jordan-malovini/sabia/hardware/caixa-3d/render-por-dentro.png

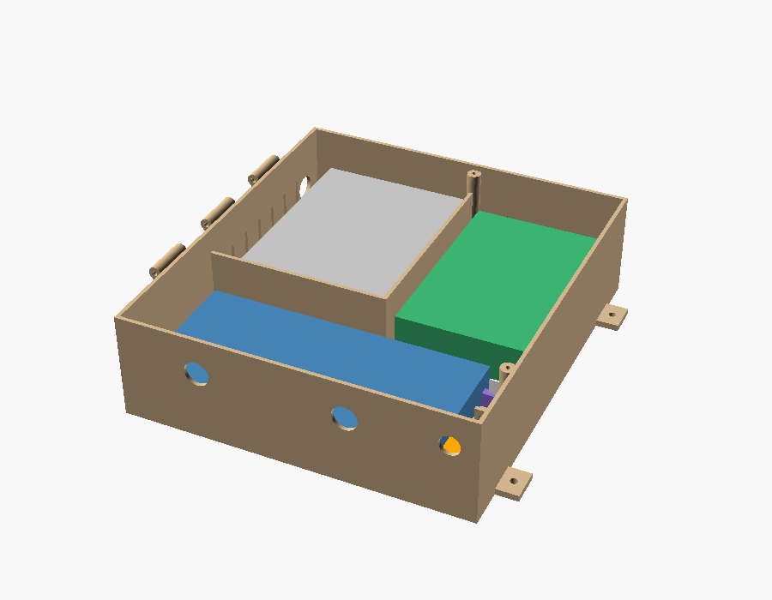
hardware/caixa-3d/render-por-dentro.png
