jordan-malovini/sabia/hardware/caixa-3d/render-tampa.png

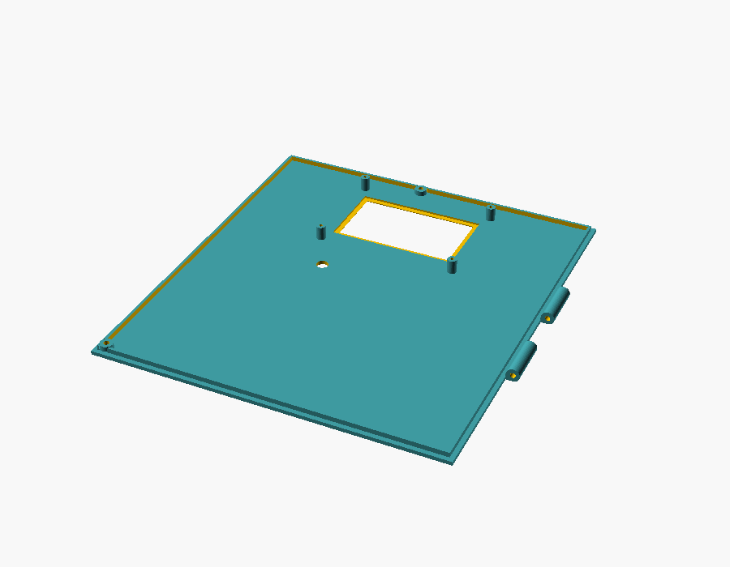
hardware/caixa-3d/render-tampa.png
