jordan-malovini/sabia/docs/diario/2026-11-11.md

# Diário: 11 de novembro de 2026

## O que fiz
- Concluí a tarefa #26: pesquisar e escolher os modelos 3D da estação meteorológica.

## O que descobri ou decidi
Modelos escolhidos:
- **Pluviômetro:** [Rain Gauge](https://www.printables.com/model/130513-rain-gauge) (Printables).
- **Abrigo anti-radiação do BME280:** [Hardware-free radiation shield](https://www.printables.com/model/1124805-hardware-free-radiation-shield-for-environmental-m) (Printables), que monta sem parafusos.
- **Cápsula do sensor de luz:** [VEML 7700 outdoor case](https://makerworld.com/pt/models/499883-veml-7700-outdoor-case#profileId-909237) (MakerWorld), feita para o VEML7700.

## Problemas
- Nenhum.

## Próximo passo
- Imprimir os três modelos em PETG ou ASA.
- Conferir no modelo do pluviômetro o volume por basculada, para ajustar `mmPorBasculada` na calibração.
- Seguem pendentes: medir os itens MEDIR da caixa quando as peças chegarem (#16) e rodar o firmware no Wokwi.
