jordan-malovini/sabia/docs/diario/2026-11-10.md

# Diário: 10 de novembro de 2026

## O que fiz
- **Medidas dos componentes (#16):** anotei as dimensões do ESP32-S3, do módulo de 16 relés, do RTC, da fonte e da placa de expansão. As da tela vieram do desenho do fabricante: placa de 93 × 70 mm, furos Ø3 a 88 × 65 mm, área visível de 72 × 40 mm e 13,5 mm de profundidade.
- **Caixa do controlador em OpenSCAD** (`hardware/caixa-3d/caixa.scad`, PRs #22, #23 e #24):
  - Base com os relés embaixo, a fonte num compartimento isolado, o ESP com a placa de expansão, suportes com parafuso, prensa-cabos, ventilação e abas de parede.
  - Tampa com dobradiça, tela atrás de um visor de acrílico, encoder e dois parafusos de fechamento.
  - Tamanho: 217,2 × 240,2 × 69,8 mm.
- **Visualização:** componentes coloridos e os modos `por_dentro`, `montagem` (transparente) e `aberta`.
- **microSD e RTC:** o microSD (18,5 × 17,5 × 5 mm, furos a 14 mm) fica em pé numa paredinha, com o cartão para a tampa e os pinos para o ESP. O RTC fica deitado sobre 3 suportes, com a pilha para a frente.
- **GitHub Actions "Caixa 3D":** gera os STL e as imagens a cada mudança e falha em qualquer aviso.
- Documentação em `docs/caixa.md` e desenho do leiaute em `tools/leiaute_caixa.py`.

## O que descobri ou decidi
- **OpenSCAD** para a caixa: o projeto é um arquivo de texto, com as medidas no topo, e cabe bem no Git.
- A fonte fica isolada por divisórias, porque é a única parte com tensão da rede. A entrada da rede é pela lateral.
- As divisórias param abaixo da tela (49,5 mm), o que permite a tela centralizada na tampa.
- No OpenSCAD, a prévia (F5) mostra cores e transparência; a renderização (F6) serve só para exportar o STL.
- A base precisa de uma impressora com mesa de pelo menos 250 × 250 mm.

## Problemas
- Conflitos de encaixe achados no leiaute e corrigidos: prensa-cabos da rede batendo na fonte, furos de baixo batendo nos módulos, tela sobre a divisória e parafusos de fechamento sobre o ESP e, depois, sobre o RTC.
- Os componentes não apareciam no OpenSCAD (fantasmas quase invisíveis e tampa fechada). Resolvido com as cores e os modos de visualização.
- O módulo microSD estava com medidas estimadas bem maiores que as reais.

## Próximo passo
- Quando as peças chegarem, medir com paquímetro os itens **MEDIR**: furos das placas de relés, de expansão e da fonte; os 3 furos do RTC; a altura dos furos e o lado dos pinos do microSD; a moldura da tela; o eixo do encoder.
- Confirmar o tamanho da mesa da impressora.
- A tarefa #16 continua em "Fazendo" até as medidas serem conferidas.
- Continuam pendentes: rodar o firmware no Wokwi, confirmar o modelo do ESP (#1) e a impressão do pluviômetro (#4).
