jordan-malovini/sabia/CHANGELOG.md

# Changelog

Formato: uma seção por versão, da mais nova para a mais antiga.

## [0.1] - em desenvolvimento

### Adicionado
- Estrutura do firmware no PlatformIO, com ambientes para o Wokwi, para a placa N16R8 e para testes no computador.
- Controlador de setores: fila com um setor por vez, modo ciclo, pular, parar setor e parar tudo, e tempo máximo por rega (RF01 a RF04, RF13).
- Sequência válvula e bomba: a bomba liga 2 s depois de a válvula abrir e desliga 1 s antes de ela fechar, com pausa de 3 s entre setores (RF05).
- Saídas configuradas como desligadas antes de virarem saída, no boot (RF14).
- Circuito do Wokwi com LEDs no lugar dos relés e comandos pelo monitor serial.
- 12 testes automáticos da fila e da sequência.
- GitHub Actions: testes e compilação do firmware a cada PR e push na `main`.
- Página web local (`firmware/data/index.html`): painel, histórico e ajustes completos, com modo demonstração enquanto o firmware não tem a API.
- Contrato da API entre a página e o firmware (`docs/api.md`).
- 31 testes de interação da página no Chrome sem janela (`tests/pagina/`).
- Logo do SABIÁ em `assets/logo/` (horizontal, com galho, só o pássaro e ícone), aplicada no README, como favicon e no topo da página web, e em 1 bit para a tela de boot do display (`firmware/include/logo_boot.h`).
- Caixa do controlador em OpenSCAD (`hardware/caixa-3d/caixa.scad`): base com divisórias, suportes, berços, prensa-cabos e abas de parede; tampa com dobradiça, tela atrás de visor de acrílico e encoder. STL gerados no GitHub Actions. Documentação em `docs/caixa.md`.
- Caixa: microSD em pé numa paredinha com 2 parafusos (cartão para a tampa, pinos para o ESP) e RTC deitado sobre 3 suportes, no lugar dos berços.
- Interface local: tela de 128x64 com a logo no boot, tela de estado e menu pelo encoder (escolher o setor, depois o tempo). Relógio e contagem de chuva do pluviômetro na tela.
- Simulação no Wokwi com tela, encoder, relógio e botão de pluviômetro.
- Monitor serial com eco do que é digitado e o comando `l` em duas etapas.
- Troca entre setores com sobreposição de 2 s e a bomba ligada do começo ao fim da fila (ideia do controlador antigo), em vez de desligar a bomba a cada setor.
- Agenda de regas com 3 programas (A, B, C): até 4 horários de início, dias da semana, ímpares, pares ou a cada N dias, tempo por setor e ajuste de 5 a 200 %. Empilhamento de programas, pausa por chuva de até 14 dias, próxima rega na tela e gravação na memória do ESP. Modelo baseado em controladores Rain Bird e Hunter.
- 14 testes da agenda, incluindo o defeito do controlador antigo (regar todos os dias no mesmo horário).
- Retomada depois de queda de energia: o setor atual, o tempo que falta e a fila são gravados; ao voltar, espera 10 min e retoma, com opção de retomar na hora ou cancelar, e descarta se a energia ficou fora por mais de 2 h.
- Edição da agenda pelo encoder ("Programar agenda"): ligar o programa, horários de início, dias (semana, ímpares, pares, intervalo), tempo de cada setor e ajuste.
- Página web no modelo de programas: agenda A, B e C nos Ajustes (horários, dias, tempo por setor, ajuste), pausa por chuva, "Iniciar programa" no painel, próxima rega por programa e ajustes de retomada e de sobreposição. `docs/api.md` atualizado; a página passa a ter 54 testes.
- Wi-Fi e servidor web no firmware: a página deixa de ser só demonstração e passa a comandar o controlador (estado, ligar, parar, programas, pausa por chuva, ajustes, retomada). A página vai embutida no firmware, numa gravação só. Rede própria (AP) com senha quando o Wi-Fi da casa falha, endereço `sabia.local`, sessão por senha (RF16) e servidor em tarefa separada, para a rede nunca atrasar válvulas e bomba.
- Limite de tempo por setor e setor desativado valem para todos os caminhos (agenda, página, encoder e serial).
- Comandos de serial `wifi`, `wifi NOME SENHA` e `senha padrao`.
- 11 testes da conversão JSON da API (`firmware/test/test_api`) e 16 testes da página contra um controlador simulado (`tests/pagina/teste-api.mjs`).
- Watchdog (RF15): se o programa travar por 15 s, o ESP reinicia com tudo desligado e a rega segue pela retomada.
- Sensores de clima: BME280 (temperatura, umidade, pressão) e VEML7700 (luz). Sem sensor, a leitura fica vazia e o resto segue normal.
- Registro (RF06, RF11): um CSV por dia com chuva a cada 10 min, clima por hora, regas e eventos, no cartão microSD ou, sem cartão, na memória do ESP. Histórico de hoje, 7 e 30 dias na página, com download em CSV.
- Balanço hídrico (RF08): ET0 por Hargreaves, saldo de água por setor e ajuste do tempo das regas automáticas. Só economiza: encurta ou pula, nunca passa do tempo do programa, e não interfere sem dados confiáveis. Adiamento automático quando chove mais que o limite em 24 h.
- Envio do registro ao Google Drive por Apps Script (`tools/drive/Codigo.gs`, passo a passo em `docs/drive.md`), apagando do cartão só depois da confirmação.
- Janela de horário por setor (RF13) nas regas da agenda, inclusive atravessando a meia-noite. Setor fora da janela, sem precisar de água ou com a rega encurtada pelo balanço fica anotado nos eventos.
- Relógio acertado pela internet (NTP) quando o Wi-Fi da casa conecta e uma vez por dia, no fuso escolhido.
- Display: tela apaga depois de um tempo sem uso (o primeiro toque só acende) e opção de travar os comandos, deixando ligar e parar só pela página.
- Script do Fusion (`hardware/caixa-3d/fusion/SabiaCaixa`) que desenha a caixa como projeto nativo, para editar pela linha do tempo. Passo a passo em `docs/caixa.md`.
- Caixa Rev B no Fusion: mais espaço para os fios dos bornes do ESP e das válvulas e para o fusível da rede (250 × 260 × 70 mm), gabarito da tela para testar o encaixe e tampa que abre na dobradiça. Os blocos dos componentes saíram.
- Nome do projeto: SABIÁ (Sistema Automático de Balanço e Irrigação Agrícola).
- Documentação dividida em README e `docs/` (requisitos, arquitetura, hardware e mapa de pinos).
- Requisitos de segurança RF14 (saídas desligadas no boot), RF15 (watchdog) e RF16 (senha e autenticação na página web).

### Alterado
- O registro de chuva passa a ser descrito em "intervalos de 10 min" (antes "balde de 10 min").
- Fica explícito que a ET0 usa só temperatura, e que umidade, pressão e luz são registradas para uso futuro.
