jordan-malovini/sabia/docs/diario/2026-11-13.md

# Diário: 13 de novembro de 2026

## O que fiz
- **Retomada depois de queda de energia e edição da agenda pelo encoder (PR #33, mesclado):** o setor atual, o tempo que falta e a fila são gravados; ao voltar, o SABIÁ espera 10 min e retoma. O menu ganhou "Programar agenda".
- **Página web no modelo de programas (PR #34, mesclado):** agenda A, B e C nos Ajustes (horários, dias, tempo por setor, ajuste), pausa por chuva, botão "Iniciar programa" no painel e os ajustes de retomada e de sobreposição. Saíram o "modo individual / modo ciclo" e os horários por setor.
- **Wi-Fi e servidor web no firmware (PR #35):** a página deixa de ser só demonstração e passa a comandar o controlador.
  - Servidor com os endereços do `docs/api.md`: estado, sessão, comandos e ajustes.
  - A página vai embutida no firmware, compactada, numa gravação só.
  - Sem Wi-Fi configurado, o SABIÁ liga a rede própria `SABIA` (senha `sabia1234`) em `http://192.168.4.1`. Com o Wi-Fi da casa, `http://sabia.local`.
  - No serial: `wifi`, `wifi NOME SENHA` e `senha padrao`.
  - Senha da página gravada só como hash; ver é livre, alterar pede a senha (RF16).
  - Os ajustes da página passam a valer de verdade: tempos da bomba, sobreposição, retomada, usar ou não a bomba, mm por basculada e, por setor, ativo, duração padrão e tempo máximo.
- **Watchdog, sensores e registro (PR #36):** watchdog de 15 s; BME280 e VEML7700; um arquivo por dia com chuva, clima, regas e eventos, no cartão microSD ou, sem cartão, na memória do ESP; histórico de hoje, 7 e 30 dias na página, com CSV.
- **Balanço hídrico e Drive (PR #37):** ET0 por Hargreaves, saldo de água por setor, adiamento automático por chuva e envio do registro ao Google Drive por Apps Script (`docs/drive.md`).
- **Janela, relógio e display (PR #38):** janela de horário por setor nas regas da agenda, relógio acertado pela internet e tela que apaga sozinha, com opção de travar os comandos.
- **Roteiro de teste no Wokwi (`docs/teste-wokwi.md`):** 9 partes, do boot à janela de horário, com o que fazer e o que deve acontecer em cada passo. Para o teste do watchdog, entrou o comando de serial `testar watchdog`, que trava o programa de propósito.
- **Teste no Wokwi (à noite):** segui o roteiro e funcionou: boot, fila e troca de setor com a bomba ligada direto, tela e encoder, queda de energia, watchdog, página web, chuva, registro e histórico. A agenda (parte 4) e a janela de horário (parte 9) ficaram para testar com tudo montado.
- **Correções para o simulador:** o firmware cresceu e o Wokwi entrava em laço no boot. Agora a compilação gera uma imagem completa da memória, com uma tabela de partições de 4 MB só no simulador (PRs #39 e #40). O serial passou a mostrar `http://localhost:8180`, o endereço que abre a página no computador (PR #41).
- **Caixa no Fusion (PRs #42 e #43):** um script desenha a caixa como projeto nativo do Fusion, editável pela linha do tempo, porque o OpenSCAD estava difícil de mexer. A tampa abre girando na dobradiça. Na Rev B, a caixa ganhou espaço para os fios dos bornes do ESP e das válvulas e para o fusível da rede (250 × 260 × 70 mm), ganhou um gabarito da tela para testar o encaixe e perdeu os blocos dos componentes.
- **Testes:** o firmware passou de 40 para mais de 80 testes de lógica (API, registro, balanço, decisor da agenda), e a página ganhou um teste contra um controlador simulado, além dos 54 do modo demonstração.

## O que descobri ou decidi
- **Um código só:** o PlatformIO junta todos os arquivos (`main.cpp`, `interface.cpp`, `web.cpp`, as bibliotecas) num único `firmware.bin`. Como a página agora vai embutida, não é preciso a segunda gravação (imagem de arquivos) que estava prevista.
- **Servidor web em tarefa separada, com trava:** se a rede travar ou um celular demorar para responder, o loop das válvulas e da bomba continua no ritmo dele.
- **Setor desativado não rega por nenhum caminho** (agenda, página, encoder ou serial), e o tempo máximo passa a ser por setor.
- **O firmware guarda a configuração inteira da página**, mesmo os campos que ainda não usa (clima, registro, display), para nada se perder quando essas partes chegarem.
- **O balanço hídrico só economiza água:** encurta ou pula a rega de um setor que ainda tem água e nunca passa do tempo do programa. Sem temperatura ou sem latitude, não interfere. Vem desligado de fábrica, até eu calibrar. Registro em `docs/decisoes/2026-11-13-balanco-hidrico-so-economiza.md`.
- **Sem cartão SD, o registro vai para a memória interna do ESP**, para o histórico funcionar desde já.
- **A luz do VEML7700 fica sem a correção do fabricante:** a fórmula dava valores absurdos na faixa do sol pleno. Como o sensor vai atrás de uma cúpula, ele pede calibração própria de qualquer jeito.

- **Fusível da rede:** 2 A retardado, num porta-fusível de linha dentro do compartimento da fonte, além do de 3 A na saída de 5 V.
- **Daqui para frente, a caixa é editada no Fusion.** O `caixa.scad` fica na Rev A.

## Problemas
- O que o Wokwi não simula ainda não rodou: sensores, display ST7920, relógio DS3231, balanço ao longo de dias e envio ao Drive.
- **Impressora:** a minha é uma Bambu Lab A1 mini (mesa de 180 × 180 mm) e a caixa não cabe nela. Vou ver na segunda se há impressoras maiores disponíveis. Com mesa de 256 mm, a caixa precisa perder as abas de parede e uns 6 mm de altura; com 300 mm, cabe como está. Outro caminho é comprar uma caixa hermética IP65 e imprimir só as peças de dentro.
- O balanço depende de parâmetros que ainda são palpites (taxa de aplicação de 2,5 mm/h, Kc 1,0) e da latitude, que ainda não informei.

## Próximo passo
- Mesclar o PR #43 (caixa Rev B no Fusion).
- Segunda: confirmar o tamanho da mesa das impressoras maiores e ajustar a caixa a ela.
- Imprimir o gabarito da tela na A1 mini quando a tela chegar.
- Informar a latitude em Ajustes → Estação e, com as peças, medir a taxa de aplicação de cada setor.
- Criar o Apps Script do Drive (`docs/drive.md`) e testar um envio.
- Seguem pendentes: medir os itens MEDIR da caixa (#16), testar agenda e janela de horário com tudo montado e imprimir o pluviômetro (#4).
