jordan-malovini/sabia/docs/diario/2026-11-12.md

# Diário: 12 de novembro de 2026

## O que fiz
- **Ambiente de desenvolvimento:** instalei o PlatformIO e o Wokwi no VS Code, compilei o firmware e rodei a simulação pela primeira vez. A fila e a sequência válvula → bomba funcionaram no simulador, com os tempos certos.
- **Tela, encoder, relógio e pluviômetro (PR #28, mesclado):** logo no boot, tela de estado e menu pelo encoder (escolher o setor, depois o tempo). No Wokwi, a tela é um OLED SSD1306 e o relógio um DS1307, porque o simulador não tem o ST7920 nem o DS3231.
- **Monitor serial:** eco do que é digitado e o comando `l` em duas etapas.
- **Troca de setor sem desligar a bomba (PR #29, mesclado):** a válvula do próximo setor abre 2 s antes de a do atual fechar. A ideia veio do controlador antigo.
- **Agenda por programas A, B e C (PR #30, mesclado):** até 4 horários por programa, dias da semana, ímpares, pares ou a cada N dias, tempo por setor, ajuste de 5 a 200 %, empilhamento, pausa por chuva e próxima rega na tela. Gravada na memória do ESP.
- Mandei o código do controlador antigo (`irrigacao_v9.ino`) para servir de base.

## O que descobri ou decidi
- **Defeito do controlador antigo:** ele guarda o horário do último ciclo sem a data (`hora × 100 + minuto`) e não inicia outro ciclo no mesmo horário. Com um ciclo só, deixa de regar no dia seguinte, até eu mexer no horário. Correção de uma linha: incluir o dia na chave. No SABIÁ, a agenda guarda a data.
- **Agenda no modelo dos controladores comerciais** (Rain Bird ESP-TM2, Hunter Pro-C e X2): 3 programas com 4 horários cada. Cada programa tem os próprios dias e o próprio tempo por setor; o horário é do programa, e os setores dele regam em sequência. Registro em `docs/decisoes/2026-11-12-agenda-por-programas.md`.
- **Bomba ligada do começo ao fim da fila**, com sobreposição das válvulas, em vez do atraso entre estações dos comerciais.
- **Queda de energia:** quero que o SABIÁ retome a rega depois de esperar a energia estabilizar, como o antigo, e não que cancele (muda o RF13).

## Problemas
- A primeira compilação falhou com `FileExistsError` na pasta `.pio`: cliquei em compilar enquanto o PlatformIO ainda configurava o projeto. Limpar e compilar de novo resolveu.
- A licença do Wokwi não entrou sozinha no VS Code. Entrou com "Wokwi: Manually Enter License Key".
- O terminal não mostrava o que eu digitava (faltava o eco). Corrigido.
- O BME280 e o VEML7700 não existem no Wokwi. Ficam para a bancada.

## Próximo passo
- Testar no Wokwi o que entrou nos PRs #29 e #30, que já estão na `main` mas ainda não rodaram no simulador: troca com sobreposição, agenda, menu novo e gravação na memória.
- Retomada após queda de energia: esperar 10 min, retomar a fila com o tempo restante, com opção de retomar na hora ou cancelar, e não retomar se a energia ficar fora por horas.
- Editar os programas pelo encoder.
- Passar a página web e o `docs/api.md` para o modelo de programas.
- Seguem pendentes: medir os itens MEDIR da caixa (#16) e imprimir o pluviômetro (#4).
