jordan-malovini/sabia/docs/diario/2026-11-09.md

# Diário: 9 de novembro de 2026

## O que fiz
- **Nome do projeto:** SABIÁ (Sistema Automático de Balanço e Irrigação Agrícola).
- **Documentação:** README curto e detalhe em `docs/` (requisitos, arquitetura, hardware, mapa de pinos, API). CHANGELOG, licenças (MIT no código, CC BY-SA no hardware) e diário com modelo.
- **GitHub:** repositório com 7 labels, 6 milestones (0.1 a 1.0), 16 issues e quadro Kanban (Ideias, A fazer, Fazendo, Testando, Feito), com limite de 3 em Fazendo.
- **Firmware v0.1 (#2 e #3):** estrutura do PlatformIO (Wokwi, placa N16R8 e testes no PC), controlador com fila de um setor por vez, modo ciclo, pular, parar e tempo máximo, e a sequência válvula → bomba → bomba desliga → válvula fecha. 12 testes automáticos e circuito no Wokwi com LEDs no lugar dos relés.
- **GitHub Actions:** testa e compila o firmware a cada mudança.
- **Página web:** um arquivo só, celular primeiro, com Painel, Histórico e Ajustes completos, login e modo demonstração. 32 testes de interação.
- **Logo:** sabiá-laranjeira pousado sobre o nome, com a gota no acento. Aplicada no README, na página e em 1 bit para o display.
- PRs mesclados: #17, #18, #19 e #20.

## O que descobri ou decidi
- **Nome:** o sabiá canta de madrugada, o melhor horário de rega, e a sigla descreve o coração do projeto, o balanço hídrico.
- **Versão começa em 0.1.** A 1.0 fica para quando o controlador estiver regando no campo.
- **Segurança:** novos requisitos RF14 (saídas desligadas no boot), RF15 (watchdog) e RF16 (senha na página).
- **Hargreaves só usa temperatura.** Umidade, pressão e luz ficam como registro, para uma fórmula mais completa no futuro.
- **Branches:** `main` só com código testado e `feature/...` para cada tarefa, sem branch `dev` (trabalho sozinho).
- **Página:** o card de luz deu lugar à evaporação (ET0). O botão "Ligar" pergunta a duração e vira "Pôr na fila" quando já tem algo regando.
- **Logo:** desenhar à mão em SVG não chegou no resultado. A versão final saiu de uma imagem minha refinada no Higgsfield.

## Problemas
- A página rolava até a seção do endereço (`#painel`) e escondia o cabeçalho. Corrigido, com um teste novo.
- O upload direto para o Higgsfield foi bloqueado pela rede; a imagem foi enviada pelo cartão do próprio Higgsfield.

## Próximo passo
- Rodar o firmware no Wokwi e abrir a página no navegador.
- Confirmar o modelo do ESP (#1) e falar com o professor sobre a impressão do pluviômetro (#4).
- Quando as peças chegarem: display com 3,3 V (#5) e relés durante o reset (#6).
- Pendentes: apagar o projeto duplicado no GitHub Projects e fazer a versão da logo para o tema escuro.
