jordan-malovini/sabia/docs/diario/_modelo.md

# Diário: DD de mês de AAAA

<!-- Copie este arquivo como AAAA-MM-DD.md e preencha. Pode apagar o que não usar. -->

## O que fiz
-

## O que descobri ou decidi
-

## Problemas
-

## Próximo passo
-

<!-- Fotos: salve em assets/ e referencie assim: ![descrição](../../assets/AAAA-MM-DD-nome.jpg) -->
<!-- Issues: cite pelo número, como #2, para ligar a entrada à tarefa. -->
