jordan-malovini/sabia/firmware/include/logo_boot.h

// Pássaro da logo do SABIÁ para a tela de boot (U8g2, formato XBM).
// Gerado a partir de assets/logo/sabia-passaro.png. Uso:
//   u8g2.drawXBMP(2, 4, LOGO_PASSARO_LARGURA, LOGO_PASSARO_ALTURA, LOGO_PASSARO);
#pragma once
#include <Arduino.h>  // PROGMEM

constexpr uint8_t LOGO_PASSARO_LARGURA = 67;
constexpr uint8_t LOGO_PASSARO_ALTURA = 56;

static const uint8_t LOGO_PASSARO[] PROGMEM = {
  0x00, 0x00, 0x00, 0x00, 0x00, 0x00, 0x00, 0x00, 0x00, 0x00, 0x00, 0x00, 0x00, 0x00, 0x00, 0x00,
  0x00, 0x00, 0x00, 0x00, 0x00, 0x00, 0x00, 0x00, 0x00, 0x00, 0x00, 0x00, 0x00, 0x00, 0x00, 0x00,
  0x80, 0x03, 0x00, 0x00, 0x00, 0x00, 0x00, 0x00, 0x00, 0xf0, 0x1f, 0x00, 0x00, 0x00, 0x00, 0x00,
  0x00, 0x00, 0xfc, 0x3f, 0x00, 0x00, 0x00, 0x00, 0x00, 0x00, 0x00, 0xfe, 0x7f, 0x00, 0x00, 0x00,
  0x00, 0x00, 0x00, 0x00, 0xff, 0xff, 0x0f, 0x00, 0x00, 0x00, 0x00, 0x00, 0x00, 0x1f, 0xf0, 0x7f,
  0x00, 0x00, 0x00, 0x00, 0x00, 0x80, 0xef, 0xff, 0x1f, 0x00, 0x00, 0x00, 0x00, 0x00, 0x80, 0xf3,
  0xff, 0x07, 0x00, 0x00, 0x00, 0x00, 0x00, 0xc0, 0xf9, 0xff, 0x03, 0x00, 0x00, 0x00, 0x00, 0x00,
  0xc0, 0xfd, 0xff, 0x00, 0x00, 0x00, 0x00, 0x00, 0x00, 0xc0, 0xfc, 0xff, 0x00, 0x00, 0x00, 0x00,
  0x00, 0x00, 0xc0, 0xfe, 0x7f, 0x00, 0x00, 0x00, 0x00, 0x00, 0x00, 0x40, 0xfe, 0x7f, 0x00, 0x00,
  0x00, 0x00, 0x00, 0x00, 0x00, 0xf0, 0x7f, 0x00, 0x00, 0x00, 0x00, 0x00, 0x00, 0xf8, 0xe7, 0x7f,
  0x00, 0x00, 0x00, 0x00, 0x00, 0x00, 0xfe, 0xcf, 0x7f, 0x00, 0x00, 0x00, 0x00, 0x00, 0x00, 0xff,
  0x9f, 0x7f, 0x00, 0x00, 0x00, 0x00, 0x00, 0x80, 0x3f, 0x80, 0x7f, 0x00, 0x00, 0x00, 0x00, 0x00,
  0xc0, 0x8f, 0x3f, 0x7f, 0x00, 0x00, 0x00, 0x00, 0x00, 0xe0, 0xf3, 0x7f, 0x7f, 0x00, 0x00, 0x00,
  0x00, 0x00, 0xf0, 0xfc, 0x7f, 0x7f, 0x00, 0x00, 0x00, 0x00, 0x00, 0x78, 0xfe, 0x7f, 0x7f, 0x00,
  0x00, 0x00, 0x00, 0x00, 0x3c, 0xff, 0x7f, 0x7f, 0x00, 0x00, 0x00, 0x00, 0x00, 0x9e, 0xff, 0x7f,
  0x7f, 0x00, 0x00, 0x00, 0x00, 0x00, 0xcf, 0xff, 0x3f, 0x3f, 0x00, 0x00, 0x00, 0x00, 0x80, 0xe7,
  0xff, 0x3f, 0x3f, 0x00, 0x00, 0x00, 0x00, 0xc0, 0xf3, 0xff, 0x9f, 0x3f, 0x00, 0x00, 0x00, 0x00,
  0xe0, 0xfd, 0xff, 0xc7, 0x1f, 0x00, 0x00, 0x00, 0x00, 0xf0, 0xfe, 0xff, 0xc0, 0x1f, 0x00, 0x00,
  0x00, 0x00, 0x78, 0xff, 0x07, 0xe7, 0x0f, 0x00, 0x00, 0x00, 0x00, 0xbc, 0x7f, 0xf0, 0xf3, 0x0f,
  0x00, 0x00, 0x00, 0x00, 0xdf, 0x83, 0xff, 0xf8, 0x07, 0x00, 0x00, 0x00, 0x00, 0x0f, 0xfc, 0x7f,
  0xfe, 0x03, 0x00, 0x00, 0x00, 0x80, 0x87, 0xff, 0x1f, 0xff, 0x01, 0x00, 0x00, 0x00, 0xe0, 0xf9,
  0xff, 0xc3, 0xff, 0x00, 0x00, 0x00, 0x00, 0x30, 0xfe, 0x3f, 0xf8, 0x7f, 0x00, 0x00, 0x00, 0x00,
  0x80, 0xff, 0x83, 0xff, 0x3f, 0x00, 0x00, 0x00, 0x00, 0xe0, 0x3f, 0xfc, 0xff, 0x0f, 0x00, 0x00,
  0x00, 0x00, 0xf8, 0xc7, 0xff, 0xff, 0x03, 0x00, 0x00, 0x00, 0x00, 0xfe, 0xc0, 0xff, 0x7f, 0x00,
  0x00, 0x00, 0x00, 0x00, 0x1f, 0x07, 0x80, 0xf3, 0x00, 0x00, 0x00, 0x00, 0xc0, 0xe3, 0x03, 0x00,
  0xe3, 0x00, 0x00, 0x00, 0x00, 0xe0, 0xfc, 0x01, 0x00, 0xc6, 0x01, 0x00, 0x00, 0x00, 0x00, 0xfe,
  0x00, 0x00, 0x8e, 0x03, 0x00, 0x00, 0x00, 0x00, 0x7f, 0x00, 0x00, 0x0c, 0x07, 0x00, 0x00, 0x00,
  0x80, 0x3f, 0x00, 0x00, 0x18, 0x06, 0x00, 0x00, 0x00, 0xc0, 0x1f, 0x00, 0x00, 0x38, 0x0c, 0x00,
  0x00, 0x00, 0xe0, 0x0f, 0x00, 0x00, 0x38, 0xfc, 0x07, 0x00, 0x00, 0xf0, 0x07, 0x00, 0x80, 0xff,
  0xff, 0x0f, 0x00, 0x00, 0xf0, 0x01, 0x00, 0x00, 0x00, 0x00, 0x00, 0x00, 0x00, 0x00, 0x00, 0x00,
  0x00, 0x00, 0x00, 0x00, 0x00, 0x00, 0x00, 0x00, 0x00, 0x00, 0x00, 0x00, 0x00, 0x00, 0x00, 0x00,
  0x00, 0x00, 0x00, 0x00, 0x00, 0x00, 0x00, 0x00
};
