jordan-malovini/sabia/firmware/include/secrets.example.h

// Modelo de credenciais do SABIÁ.
// Copie este arquivo para "secrets.h" na mesma pasta e preencha os valores.
// O secrets.h está no .gitignore e nunca deve ir para o repositório.
//
// É opcional: sem o secrets.h, o firmware usa a rede própria "SABIA" e a
// senha "sabia1234" (rede e página), e tudo se troca depois pela página.
// Com o secrets.h, estes valores valem até serem trocados pela página.
// Hoje o firmware usa WIFI_SSID, WIFI_PASSWORD, AP_PASSWORD e WEB_PASSWORD.

#pragma once

// Wi-Fi da casa
#define WIFI_SSID        "nome-da-rede"
#define WIFI_PASSWORD    "senha-da-rede"

// Wi-Fi próprio do SABIÁ (modo AP), usado quando a rede da casa falha
#define AP_SSID          "SABIA"
#define AP_PASSWORD      "troque-esta-senha"   // mínimo de 8 caracteres

// Senha da página web para ligar, parar e alterar ajustes
#define WEB_USER         "admin"
#define WEB_PASSWORD     "troque-esta-senha"

// Envio ao Google Drive (URL de implantação do Google Apps Script)
#define DRIVE_SCRIPT_URL "https://script.google.com/macros/s/SEU_ID/exec"

// Localização (usada no cálculo da radiação Ra do Hargreaves)
#define LATITUDE_GRAUS   0.0      // preencha com a latitude do local (sul é negativo)
