jordan-malovini/sabia/(commit log)

2026-11-10 docs: modelo de entrada do diário de bordo
    Claude-Session: https://claude.ai/code/session_01LaK3UAtjrPCuA6B4eXAfcY
2026-11-10 feat: fila de setores e sequência válvula/bomba
    Controlador em lógica pura (lib/Irrigacao), com testes no computador,
    firmware de teste pelo monitor serial e circuito do Wokwi.
    Closes #2, closes #3
    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
2026-11-10 feat: página web local (painel, histórico e ajustes)
    Página única em firmware/data, sem framework e sem fonte externa, celular
    primeiro. Funciona em modo demonstração até o firmware ter a API, cujo
    contrato está em docs/api.md. Inclui testes de interação no Chrome sem janela.
    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
2026-11-10 feat: logo do SABIÁ
    Logo em assets/logo (horizontal, com galho, pássaro e ícone), aplicada no
    README, como favicon e no topo da página web, e em 1 bit para o display.
    Corrige também o salto da página até a seção do endereço (#painel), que
    escondia o cabeçalho ao abrir.
    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
    [logo_boot.h]
2026-11-10 docs: diário de 9 de novembro
    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
2026-11-10 feat: caixa do controlador em OpenSCAD (rascunho)
    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
    [caixa.scad]
2026-11-10 fix: ressaltos de fechamento sem tangência; CI falha em sólido inválido
    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
    [caixa.scad]
2026-11-10 feat: rebaixo para visor de acrílico na janela da tela
    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
    [caixa.scad]
2026-11-10 docs: documentação da caixa, imagens e STL pelo GitHub Actions
    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
2026-11-11 feat: componentes coloridos, modo por_dentro e tampa transparente na montagem
    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
    [caixa.scad]
2026-11-11 fix: componentes visíveis na montagem transparente
    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
    [caixa.scad]
2026-11-11 feat: microSD em pé e RTC parafusado na caixa
    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
    [caixa.scad]
2026-11-11 fix: parafuso de fechamento fora do RTC
    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
    [caixa.scad]
2026-11-11 docs: diário de 10 de novembro
    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
2026-11-11 docs: diário de 11 de novembro
    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
2026-11-12 feat: tela, encoder, relógio e pluviômetro no firmware e no Wokwi
    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
2026-11-12 feat: troca de setor com sobreposição, sem desligar a bomba
    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
2026-11-12 feat: agenda de regas por programas (A, B, C)
    Modelo dos controladores comerciais: até 4 inícios por programa, dias da
    semana/ímpares/pares/intervalo, tempo por setor, ajuste percentual,
    empilhamento e pausa por chuva. Gravação em NVS, comandos no serial e
    itens no menu do encoder.
    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
2026-11-12 docs: diário de 12 de novembro
    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
2026-11-13 feat: retomada após queda de energia e edição da agenda pelo encoder
    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
2026-11-13 Página web no modelo de programas A, B e C
    Sai o modo individual/ciclo com horários por setor; entram os três
    programas da Agenda do firmware (até 4 inícios, dias por semana,
    ímpares, pares ou intervalo, tempo por setor e ajuste de 5 a 200 %),
    pausa por chuva, iniciar programa pelo painel e os ajustes de retomada
    após queda de energia e de sobreposição na troca de setor.
    docs/api.md acompanha o novo contrato.
    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
2026-11-13 Wi-Fi e servidor web: a página passa a comandar o controlador
    - Servidor (src/web.cpp) com os endereços de docs/api.md: estado, sessão,
    comandos, configuração. Roda em tarefa própria, com trava, para a rede
    nunca atrasar a sequência de válvulas e bomba.
    - Página embutida no firmware (embutir_pagina.py gera include/pagina_gz.h).
    - Wi-Fi da casa com rede própria (AP, com senha) quando ele falha; mDNS
    sabia.local; comandos de serial wifi e senha padrao.
    - Senha da página como hash com sal, sessão por cookie HttpOnly (RF16).
    - lib/Api: conversão e validação do JSON, com 11 testes no computador.
    - Controlador: limite de tempo por setor e setor desativado.
    - Página: aceita ca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
2026-11-13 Diário de 13 de novembro
    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
2026-11-13 Watchdog, sensores de clima e registro com histórico
    - Watchdog de 15 s na tarefa do loop (RF15); o motivo do reinício vai para
    o registro.
    - BME280 (Adafruit) e VEML7700 (direto no I2C); sem sensor, leitura vazia.
    - Registro do dia em CSV no cartão microSD ou, sem cartão, na flash
    (LittleFS): chuva a cada 10 min, clima por hora, regas e eventos; resumo
    por dia para os períodos de 7 e 30 dias. O dia é refeito ao reiniciar.
    - /api/historico e /api/csv com dados reais; clima e cartão no estado.
    - Página: gráficos aceitam horas e dias sem leitura.
    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
2026-11-13 Balanço hídrico, adiamento por chuva e envio ao Drive
    - Balanço hídrico por setor (RF08): ET0 por Hargreaves com Ra da FAO-56,
    saldo fechado uma vez por dia e guardado na memória. Nas regas
    automáticas, encurta ou pula; nunca passa do tempo do programa e não
    interfere sem dados confiáveis.
    - Adiamento automático quando chove mais que o limite em 24 h.
    - Agenda: gancho Decisor, que não vale para início manual.
    - Dia que ficou sem fechar (controlador desligado na virada) é fechado ao ligar.
    - Envio do registro ao Google Drive por Apps Script (RF11), com
    confirmação antes de liberar a limpeza do cartão.
    - Página: saldo de água por setor, aviso de adiamento, estado do Dr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
    [balanco.cpp, config.cpp, drive.cpp, main.cpp, registro.cpp, sistema.h, web.cpp]
2026-11-13 Balanço desligado de fábrica e diário atualizado
    - O balanço hídrico só passa a mexer nas regas quando ligado nos ajustes,
    depois de informar a latitude e medir a taxa de cada setor.
    - Uso do cartão SD não é mais medido (a conta pode passar do watchdog).
    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
2026-11-13 Janela de horário por setor, relógio pela internet e ajustes do display
    - Janela de horário (RF13) nas regas da agenda: o decisor sabe quando cada
    setor vai começar e pula o que cair fora da janela.
    - Eventos para setor fora da janela, sem precisar de água, rega encurtada
    pelo balanço e rega adiada pela chuva.
    - NTP com o Wi-Fi da casa: confere ao conectar e uma vez por dia, acerta o
    RTC se errado por 2 s ou mais, no fuso escolhido.
    - Display: tela apaga depois do tempo escolhido e opção de travar comandos.
    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
2026-11-13 Wokwi: imagem completa da flash, para o boot não entrar em laço
    Com só o firmware.bin, o Wokwi usa uma tabela de partições própria, com
    1,25 MB para o programa. O firmware passou de 1,4 MB e o ESP simulado
    reiniciava sem parar (rst:0x3) antes de rodar o setup. Agora a compilação
    do esp32s3 gera sabia-wokwi.bin (bootloader + partições + programa) e o
    wokwi.toml aponta para ela. A verificação automática confere a imagem.
    Também tira o aviso de texto cortado em web.cpp.
    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
2026-11-13 Wokwi: tabela de partições de 4 MB no simulador
    O ESP32-S3 do Wokwi tem 4 MB de flash, e a tabela padrão da placa é de
    8 MB: o bootloader recusava a tabela (partition 3 invalid). No ambiente do
    simulador, a tabela passa a ser a huge_app (3 MB de programa). A placa real
    não muda. A verificação automática confere se as partições cabem em 4 MB.
    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
2026-11-13 Simulador: mostrar no serial o endereço que abre a página (localhost:8180)
    No Wokwi, o IP do ESP (10.13.37.2) e o sabia.local não abrem do computador.
    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
2026-11-13 Roteiro de teste no Wokwi e diário do dia
    - docs/teste-wokwi.md: 9 partes com o que fazer e o que esperar.
    - Comando de serial 'testar watchdog', que trava o loop de propósito.
    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
2026-11-13 Caixa no Fusion: script que desenha a base, a tampa e os componentes
    Projeto nativo do Fusion, com cada parte num esboço e numa extrusão com
    nome, para editar pela linha do tempo. Mesmas medidas do caixa.scad (Rev A).
    Passo a passo em docs/caixa.md.
    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
2026-11-14 Caixa no Fusion: tampa ligada à base por uma junta de rotação na dobradiça
    A tampa abre arrastando com o mouse, até 110 graus. Base e componentes
    ficam fixos, e o bloco da tela passa para a Tampa, para abrir junto.
    Se a junta falhar, o script avisa e o resto do desenho continua.
    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
2026-11-14 Fusion: dobradiça gira no eixo do pino e descobre o lado de abrir
    A junta usava o Y do esboço, que no plano XZ aponta para fora da tampa: a
    tampa girava de lado. Agora usa o Z do esboço (a normal do plano), que é o
    eixo do pino. O script gira a tampa 60 graus para testar o sentido e põe
    os limites de 0 a 110 graus do lado em que ela se afasta da caixa.
    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
2026-11-14 Caixa Rev B no Fusion: mais espaço para os cabos, gabarito da tela e fusível
    - Folga de 5 mm, 12 mm dos dois lados da placa do ESP (bornes), 17 mm
    embaixo dos relés (fios das válvulas) e 25 mm à esquerda da fonte (rede
    e porta-fusível de linha). Caixa passa a 250 x 260 x 70 mm.
    - Gabarito da tela: pedaço da tampa com janela e suportes, ao lado da caixa.
    - Saem os blocos dos componentes.
    - Fusível de 2 A retardado na entrada da rede (docs/caixa.md, docs/hardware.md).
    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
2026-11-14 Diário de 13/11: testes no Wokwi, correções do simulador e caixa no Fusion
    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
